marrold/Tait_TM8XXX_TNC_Adapter/images/Tait_Lid.jpg

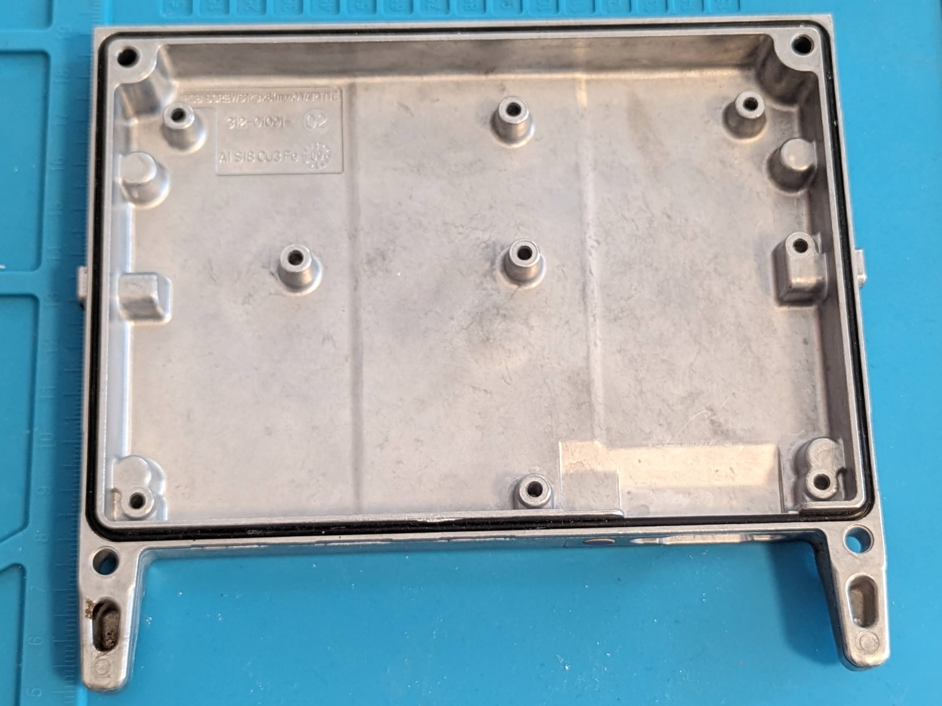
images/Tait_Lid.jpg
