marrold/Tait_TM8XXX_TNC_Adapter/Tait_TM8XXX_TNC_Adapter.kicad_pcb

## KiCad design Tait_TM8XXX_TNC_Adapter.kicad_pcb (2024-01-03)

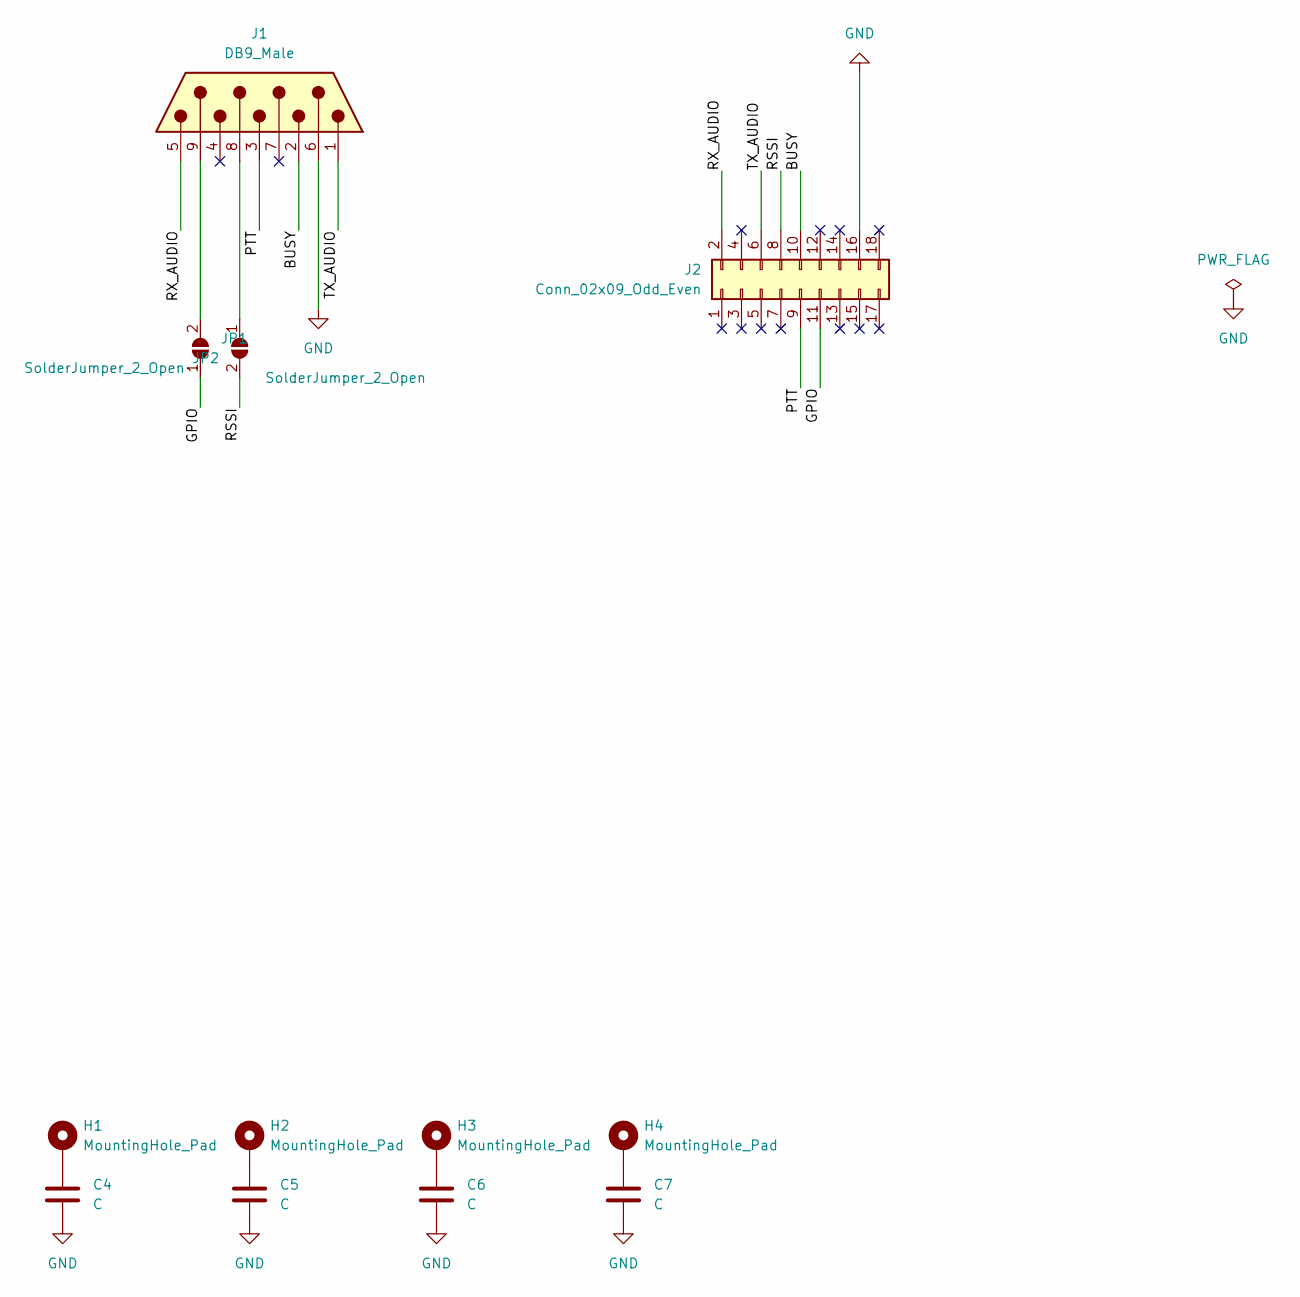
[picture p7: schematic Tait_TM8XXX_TNC_Adapter.kicad_sch]

Parts:
C4, C5, C6, C7: C; C_0805_2012Metric_Pad1.18x1.45mm_HandSolder
H1, H2, H3, H4: MountingHole_Pad; MountingHole_3.2mm_M3_Pad
J1: DB9_Male; DB9_Ultra-Thin_Male
J2: Conn_02x09_Odd_Even; MicroMatch-18p-SMD
JP1, JP2: SolderJumper_2_Open; SolderJumper-2_P1.3mm_Open_RoundedPad1.0x1.5mm

Connections:
/BUSY: J1.2, J2.10
/GPIO: J2.11, JP1.1 (A)
/PTT: J1.3, J2.9
/RSSI: J2.8, JP2.2 (B)
/RX_AUDIO: J1.5, J2.2
/TX_AUDIO: J1.1, J2.6
GND: C4.2, C5.2, C6.2, C7.2, J1.6, J2.16
unnamed: C4.1, H1.1
unnamed: C5.1, H2.1
unnamed: C6.1, H3.1
unnamed: C7.1, H4.1
unnamed: J1.8, JP2.1 (A)
unnamed: J1.9, JP1.2 (B)

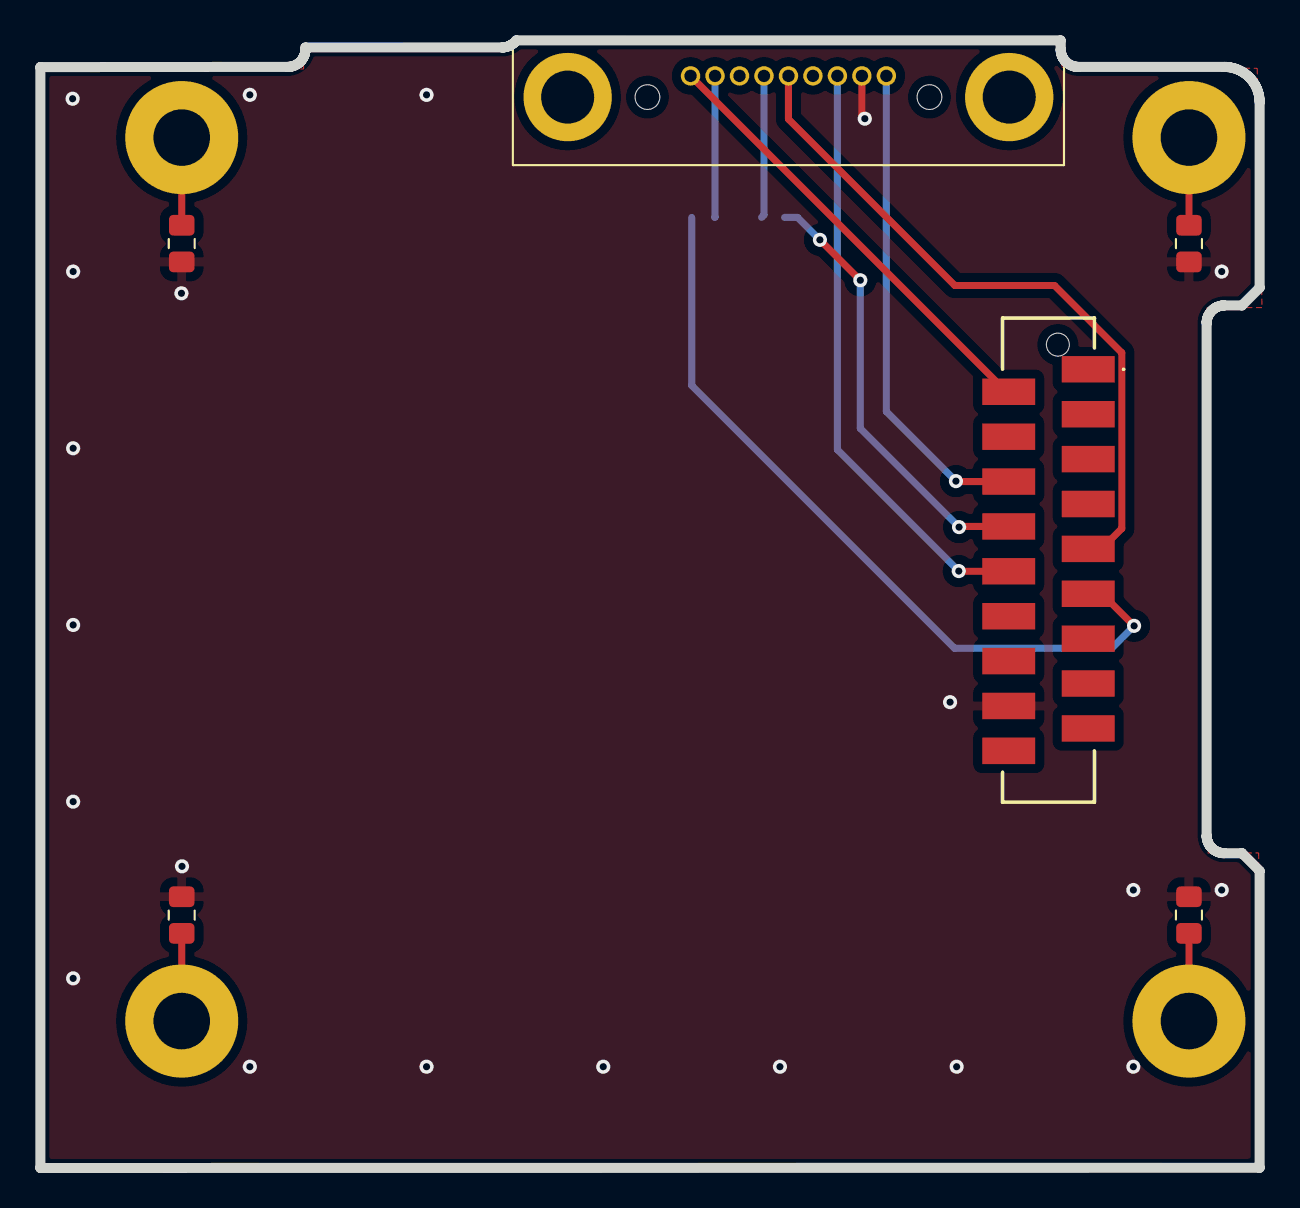
[picture p8: board Tait_TM8XXX_TNC_Adapter.kicad_pcb from above]

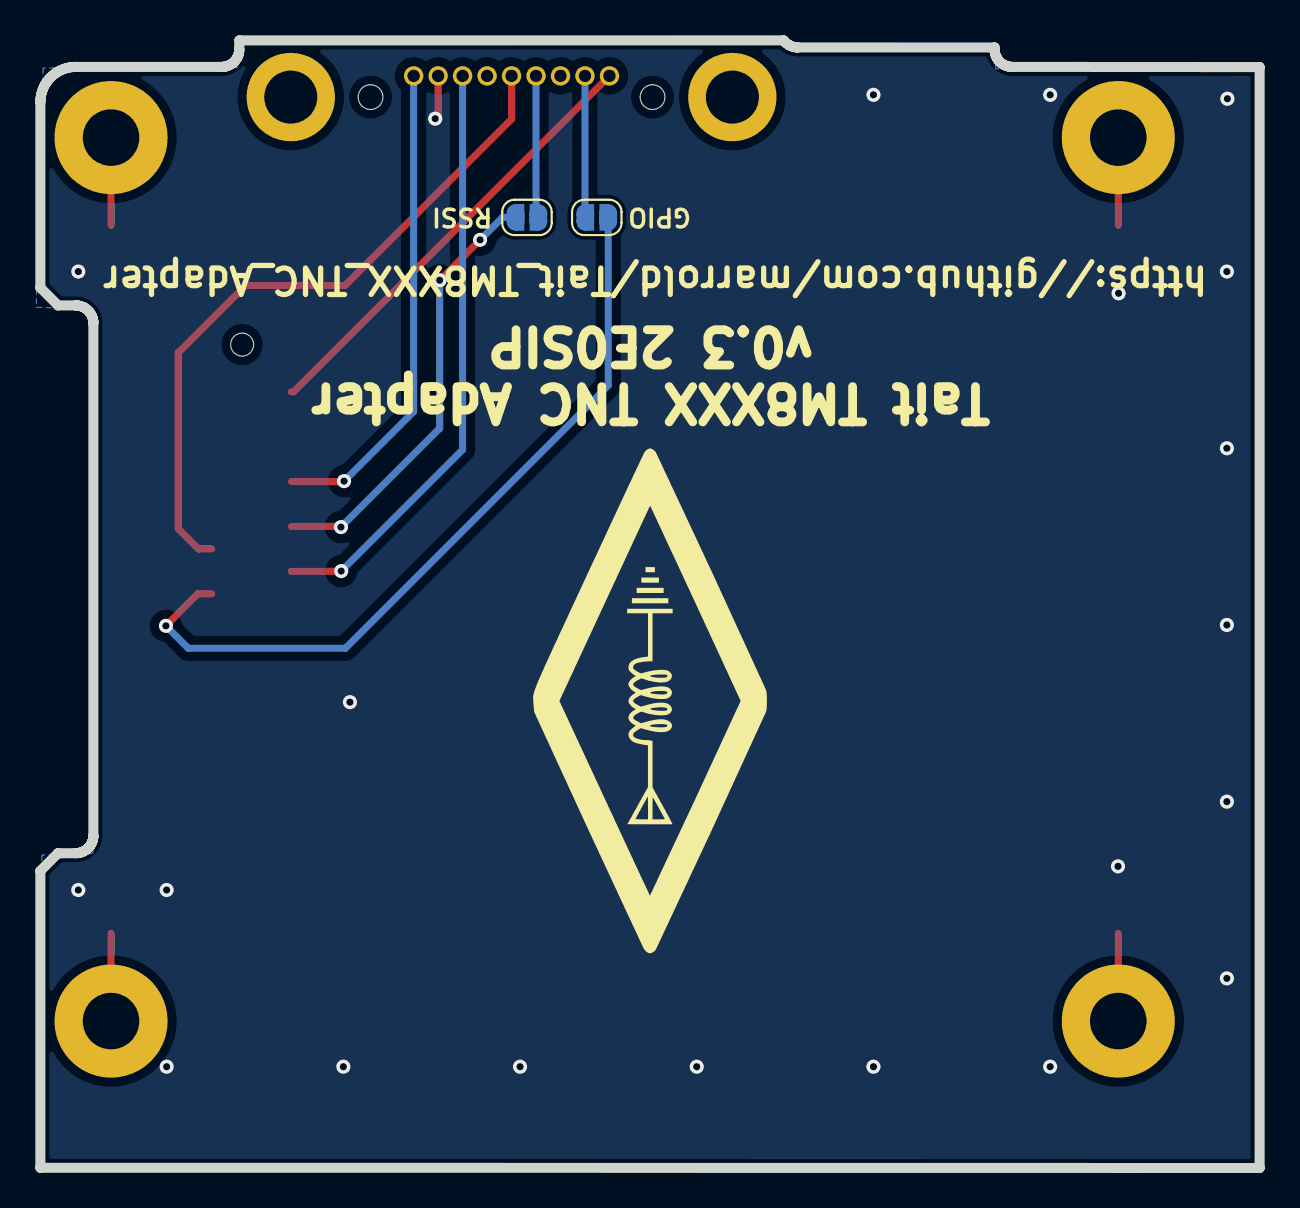
[picture p9: board Tait_TM8XXX_TNC_Adapter.kicad_pcb from below]

Board: 2 copper layers, 69.0 x 63.8 mm, 12 parts (2 on the bottom side), 13 nets.
